dankar/nanoaltair8800/(commit log)

2021-05-12 Fixed docker to use mounted volume for project files, and correct user/group set on build files.
2021-05-20 Moved hardware project from unnecessary subfolder
    [led_display.sch, nanoaltair.kicad_pcb, nanoaltair.sch]
